I-dont-knoww/RobotTourV2/electronics/encoderpcb/jlcpcb/production_files/BOM-rotour_mt6701_breakout.csv

Comment | Designator | Footprint | LCSC | Quantity
100n | C1 | C_0402_1005Metric | C1525 | 1
Conn_01x07_MountingPin | J1 | JST_SH_SM07B-SRSS-TB_1x07-1MP_P1.00mm_Horizontal | C160406 | 1
5.6 | D1 | D_SOD-123 | C19077402 | 1
MT6701QT | U1 | QFN-16-1EP_3x3mm_P0.5mm_EP1.7x1.7mm | C2913974 | 1
