I-dont-knoww/RobotTourV2/electronics/mainpcb/IC12_MP6550_MNP.step

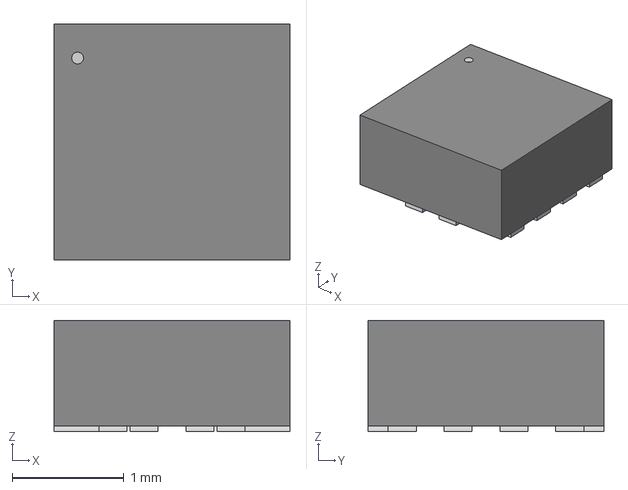
[picture p1: CAD file, 2026-01-05]
electronics/mainpcb/IC12_MP6550_MNP.step
2.11 x 2.11 x 0.993 mm
