I-dont-knoww/RobotTourV2/electronics/mainpcb/TS-1088-AR02016.step

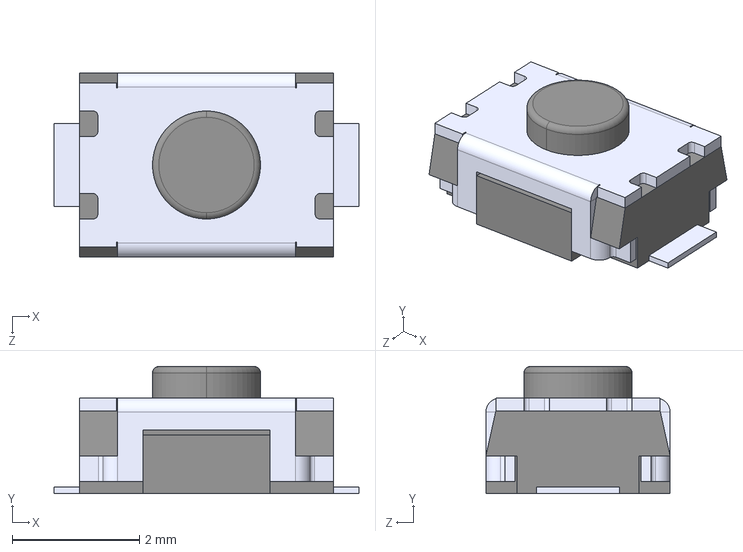
[picture p2: CAD file, 2026-01-05]
electronics/mainpcb/TS-1088-AR02016.step
4.80 x 2.00 x 2.90 mm
