I-dont-knoww/RobotTourV2/electronics/mainpcb/ICM42688.step

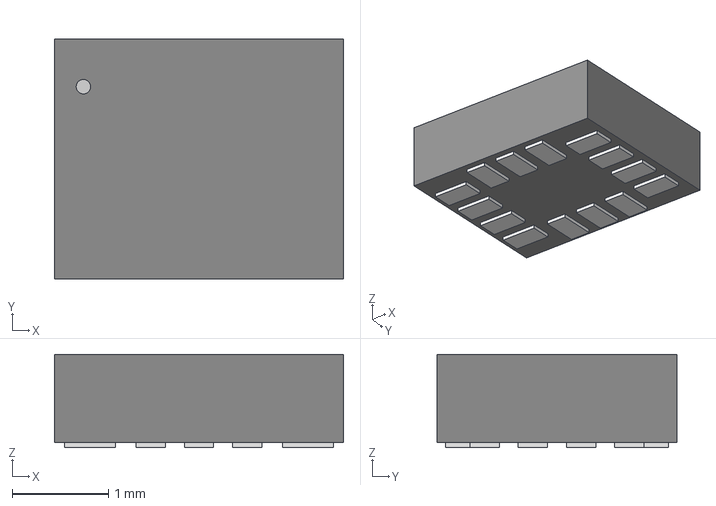
[picture p3: CAD file, 2026-01-05]
electronics/mainpcb/ICM42688.step
3.00 x 2.49 x 0.968 mm
