I-dont-knoww/RobotTourV2/electronics/mainpcb/rotour_v2.kicad_pcb

## KiCad design electronics/mainpcb/rotour_v2.kicad_pcb (2026-04-16)

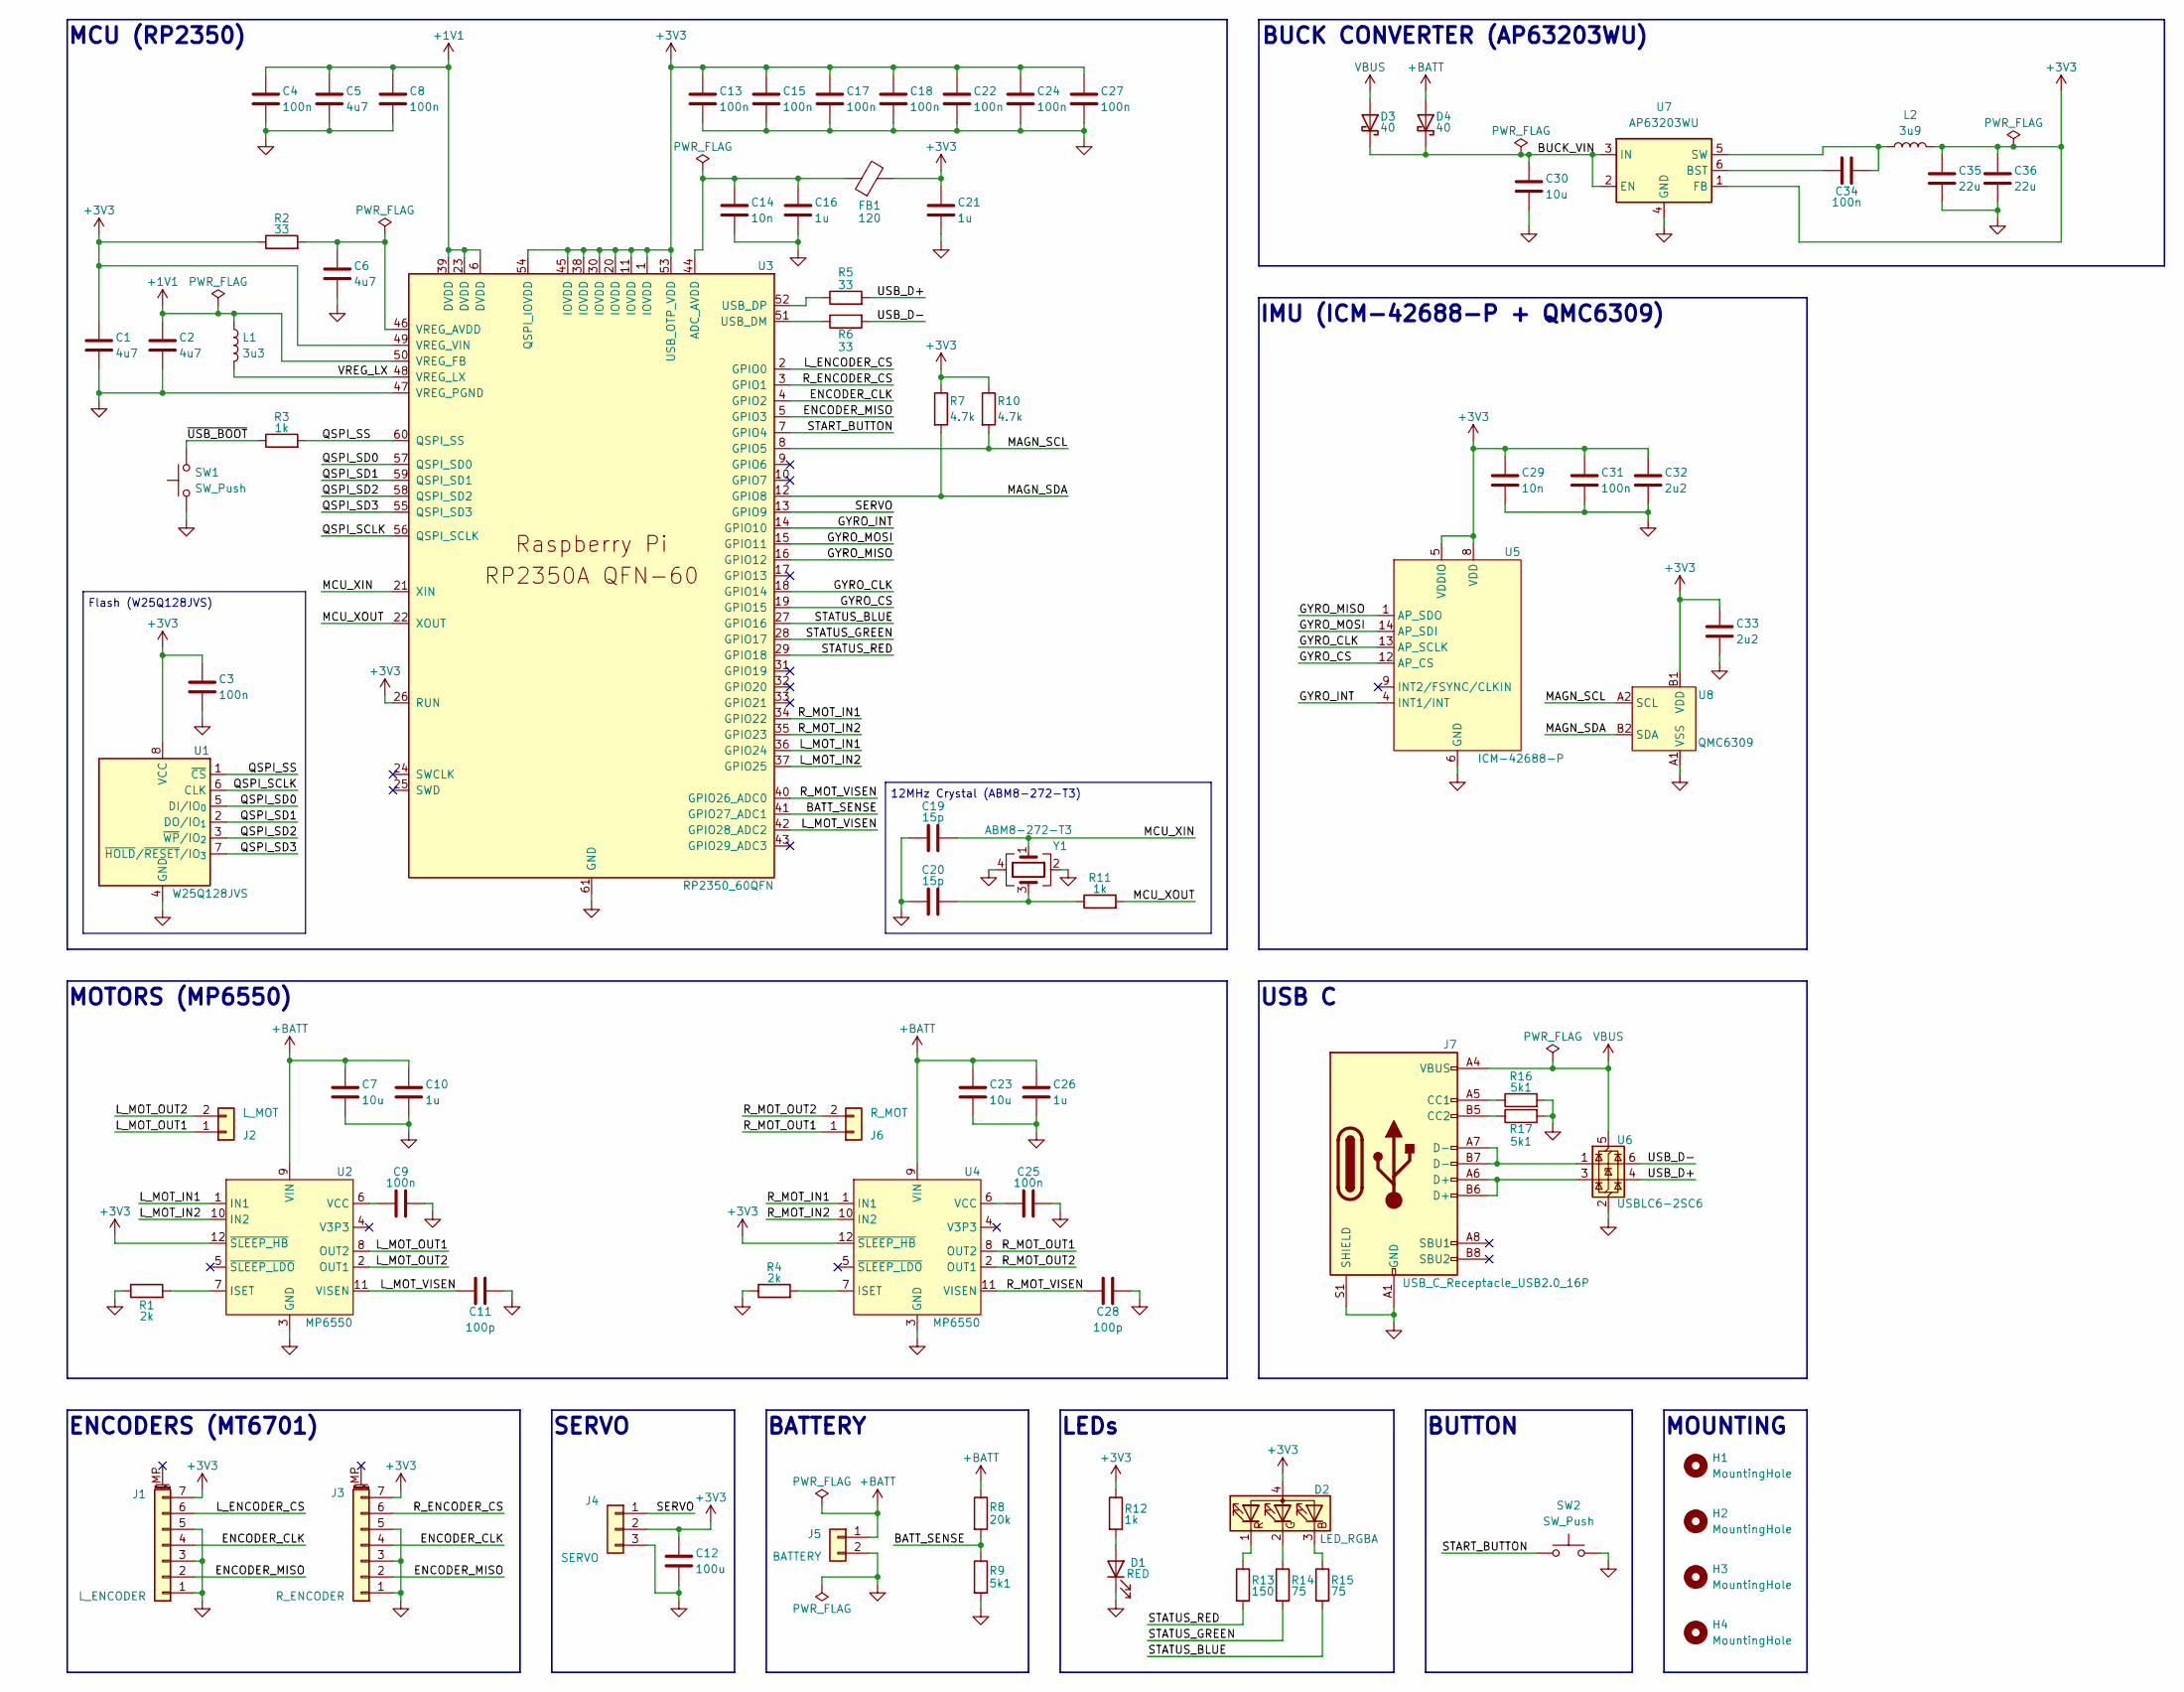
[picture p4: schematic rotour_v2.kicad_sch]

Parts:
C1, C2: 4u7; C_0402_1005Metric_small_pads
C3, C4, C8, C9, C13, C15, C17, C18, C22, C24, C25, C27, C31, C34: 100n; C_0402_1005Metric
C5, C6: 4u7; C_0402_1005Metric
C7, C23, C30: 10u; C_0603_1608Metric
C10, C16, C21, C26: 1u; C_0402_1005Metric
C11, C28: 100p; C_0402_1005Metric
C12: 100u; C_1206_3216Metric
C14, C29: 10n; C_0402_1005Metric
C19, C20: 15p; C_0402_1005Metric
C32, C33: 2u2; C_0402_1005Metric
C35, C36: 22u; C_0603_1608Metric
D1: RED; LED_0603_1608Metric
D2: LED_RGBA; LED_RGB_1210
D3, D4: 40; D_SOD-323
FB1: 120; L_0603_1608Metric
H1, H2, H3, H4: MountingHole; MountingHole_2.2mm_M2
J1: L_ENCODER; JST_SH_BM07B-SRSS-TB_1x07-1MP_P1.00mm_Vertical
J2: L_MOT; JST_XH_B2B-XH-A_1x02_P2.50mm_Vertical
J3: R_ENCODER; JST_SH_BM07B-SRSS-TB_1x07-1MP_P1.00mm_Vertical
J4: SERVO; PinHeader_1x03_P2.54mm_Vertical
J5: BATTERY; JST_VH_B2P-VH_1x02_P3.96mm_Vertical
J6: R_MOT; JST_XH_B2B-XH-A_1x02_P2.50mm_Vertical
J7: USB_C_Receptacle_USB2.0_16P; USB_C_Receptacle_GCT_USB4105-xx-A_16P_TopMnt_Horizontal
L1: 3u3; AOTA-B201610S3R3-101-T
L2: 3u9; L_Changjiang_FNR3012S
R1, R4: 2k; R_0402_1005Metric
R2, R5, R6: 33; R_0402_1005Metric
R3, R11, R12: 1k; R_0402_1005Metric
R7, R10: 4.7k; R_0402_1005Metric
R8: 20k; R_0603_1608Metric
R9, R16, R17: 5k1; R_0402_1005Metric
R13: 150; R_0603_1608Metric
R14, R15: 75; R_0603_1608Metric
SW1, SW2: SW_Push; SW_TS-1088-AR02016
U1: W25Q128JVS; SOIC-8_5.3x5.3mm_P1.27mm
U2, U4: MP6550
U3: RP2350_60QFN; QFN-60-1EP_7x7mm_P0.4mm_EP3.4x3.4mm_ThermalVias
U5: ICM-42688-P; ICM42688P
U6: USBLC6-2SC6; SOT-23-6
U7: AP63203WU; TSOT-23-6
U8: QMC6309
Y1: ABM8-272-T3; Crystal_SMD_3225-4Pin_3.2x2.5mm

Connections:
+1V1: C2.1, C4.1, C5.1, C8.1, L1.1, U3.6 (DVDD), U3.23 (DVDD), U3.39 (DVDD), U3.50 (VREG_FB)
+3V3: C1.1, C3.1, C12.1, C13.1, C15.1, C17.1, C18.1, C21.1, C22.1, C24.1, C27.1, C29.1, C31.1, C32.1, C33.1, C35.1, C36.1, D2.4 (A), FB1.2, J1.7, J3.7, J4.2, L2.2, R2.1, R7.1, R10.1, R12.1, U1.8 (VCC), U2.12 (~SLEEP_HB), U3.1 (IOVDD), U3.11 (IOVDD), U3.20 (IOVDD), U3.26 (RUN), U3.30 (IOVDD), U3.38 (IOVDD), U3.45 (IOVDD), U3.49 (VREG_VIN), U3.53 (USB_OTP_VDD), U3.54 (QSPI_IOVDD), U4.12 (~SLEEP_HB), U5.5 (VDDIO), U5.8 (VDD), U7.1 (FB), U8.B1 (VDD)
+BATT: C7.1, C10.1, C23.1, C26.1, D4.2 (A), J5.1, R8.1, U2.9 (VIN), U4.9 (VIN)
/BATT_SENSE: R8.2, R9.1, U3.41 (GPIO27_ADC1)
/BUCK_VIN: C30.1, D3.1 (K), D4.1 (K), U7.2 (EN), U7.3 (IN)
/ENCODER_CLK: J1.4, J3.4, U3.4 (GPIO2)
/ENCODER_MISO: J1.2, J3.2, U3.5 (GPIO3)
/GYRO_CLK: U3.18 (GPIO14), U5.13 (AP_SCLK)
/GYRO_CS: U3.19 (GPIO15), U5.12 (AP_CS)
/GYRO_INT: U3.14 (GPIO10), U5.4 (INT1/INT)
/GYRO_MISO: U3.16 (GPIO12), U5.1 (AP_SDO)
/GYRO_MOSI: U3.15 (GPIO11), U5.14 (AP_SDI)
/L_ENCODER_CS: J1.6, U3.2 (GPIO0)
/L_MOT_IN1: U2.1 (IN1), U3.36 (GPIO24)
/L_MOT_IN2: U2.10 (IN2), U3.37 (GPIO25)
/L_MOT_OUT1: J2.1, U2.8 (OUT2)
/L_MOT_OUT2: J2.2, U2.2 (OUT1)
/L_MOT_VISEN: C11.1, U2.11 (VISEN), U3.42 (GPIO28_ADC2)
/MAGN_SCL: R10.2, U3.8 (GPIO5), U8.A2 (SCL)
/MAGN_SDA: R7.2, U3.12 (GPIO8), U8.B2 (SDA)
/MCU_XIN: C19.2, U3.21 (XIN), Y1.1
/MCU_XOUT: R11.2, U3.22 (XOUT)
/QSPI_SCLK: U1.6 (CLK), U3.56 (QSPI_SCLK)
/QSPI_SD0: U1.5 (DI/IO_{0}), U3.57 (QSPI_SD0)
/QSPI_SD1: U1.2 (DO/IO_{1}), U3.59 (QSPI_SD1)
/QSPI_SD2: U1.3 (~WP/IO_{2}), U3.58 (QSPI_SD2)
/QSPI_SD3: U1.7 (~HOLD/~RESET/IO_{3}), U3.55 (QSPI_SD3)
/QSPI_SS: R3.2, U1.1 (~CS), U3.60 (QSPI_SS)
/R_ENCODER_CS: J3.6, U3.3 (GPIO1)
/R_MOT_IN1: U3.34 (GPIO22), U4.1 (IN1)
/R_MOT_IN2: U3.35 (GPIO23), U4.10 (IN2)
/R_MOT_OUT1: J6.1, U4.8 (OUT2)
/R_MOT_OUT2: J6.2, U4.2 (OUT1)
/R_MOT_VISEN: C28.1, U3.40 (GPIO26_ADC0), U4.11 (VISEN)
/SERVO: J4.1, U3.13 (GPIO9)
/START_BUTTON: SW2.1, U3.7 (GPIO4)
/STATUS_BLUE: R15.2, U3.27 (GPIO16)
/STATUS_GREEN: R14.2, U3.28 (GPIO17)
/STATUS_RED: R13.2, U3.29 (GPIO18)
/USB_D+: R5.2, U6.4 (I/O2)
/USB_D-: R6.2, U6.6 (I/O1)
/VREG_LX: L1.2, U3.48 (VREG_LX)
/~USB_BOOT: R3.1, SW1.2
GND: C1.2, C2.2, C3.2, C4.2, C5.2, C6.2, C7.2, C8.2, C9.2, C10.2, C11.2, C12.2, C13.2, C14.2, C15.2, C16.2, C17.2, C18.2, C19.1, C20.1, C21.2, C22.2, C23.2, C24.2, C25.2, C26.2, C27.2, C28.2, C29.2, C30.2, C31.2, C32.2, C33.2, C35.2, C36.2, D1.1 (K), J1.1, J1.3, J1.5, J3.1, J3.3, J3.5, J4.3, J5.2, J7.A1 (GND), J7.A12 (GND), J7.B1 (GND), J7.B12 (GND), J7.S1 (SHIELD), R1.1, R4.1, R9.2, R16.2, R17.2, SW1.1, SW2.2, U1.4 (GND), U2.3 (GND), U3.47 (VREG_PGND), U3.61 (GND), U4.3 (GND), U5.6 (GND), U5.7 (RESV), U5.11 (RESV), U6.2 (GND), U7.4 (GND), U8.A1 (VSS), Y1.2, Y1.4
unnamed: C20.2, R11.1, Y1.3
unnamed: D1.2 (A), R12.2
unnamed: D2.3 (BK), R15.1
unnamed: D2.2 (GK), R14.1
unnamed: D2.1 (RK), R13.1
unnamed: J7.A5 (CC1), R16.1
unnamed: J7.B5 (CC2), R17.1
unnamed: J7.A6 (D+), J7.B6 (D+), U6.3 (I/O2)
unnamed: J7.A7 (D-), J7.B7 (D-), U6.1 (I/O1)
unnamed: R1.2, U2.7 (ISET)
unnamed: C9.1, U2.6 (VCC)
unnamed: C14.1, C16.1, FB1.1, U3.44 (ADC_AVDD)
unnamed: R6.1, U3.51 (USB_DM)
unnamed: R5.1, U3.52 (USB_DP)
unnamed: C6.1, R2.2, U3.46 (VREG_AVDD)
unnamed: R4.2, U4.7 (ISET)
unnamed: C25.1, U4.6 (VCC)
unnamed: C34.2, U7.6 (BST)
unnamed: C34.1, L2.1, U7.5 (SW)
VBUS: D3.2 (A), J7.A4 (VBUS), J7.A9 (VBUS), J7.B4 (VBUS), J7.B9 (VBUS), U6.5 (VBUS)

Notes on the sheet:
BUCK CONVERTER (AP63203WU)
USB C
IMU (ICM-42688-P + QMC6309)
ENCODERS (MT6701)
BUTTON
MOTORS (MP6550)
SERVO
Flash (W25Q128JVS)
LEDs
MCU (RP2350)
12MHz Crystal (ABM8-272-T3)
BATTERY
MOUNTING

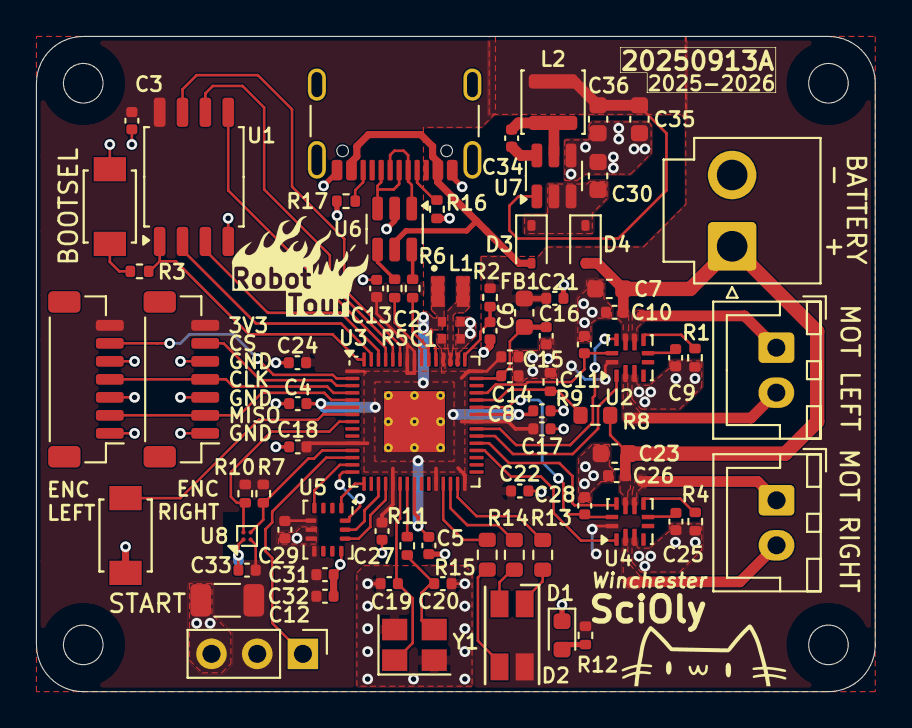
[picture p5: board rotour_v2.kicad_pcb from above]

Board: 2 copper layers, 46.6 x 36.4 mm, 82 parts (0 on the bottom side), 64 nets.
