I-dont-knoww/RobotTourV2/electronics/encoderpcb/rotour_mt6701_breakout.kicad_pcb

## KiCad design electronics/encoderpcb/rotour_mt6701_breakout.kicad_pcb (2026-01-05)

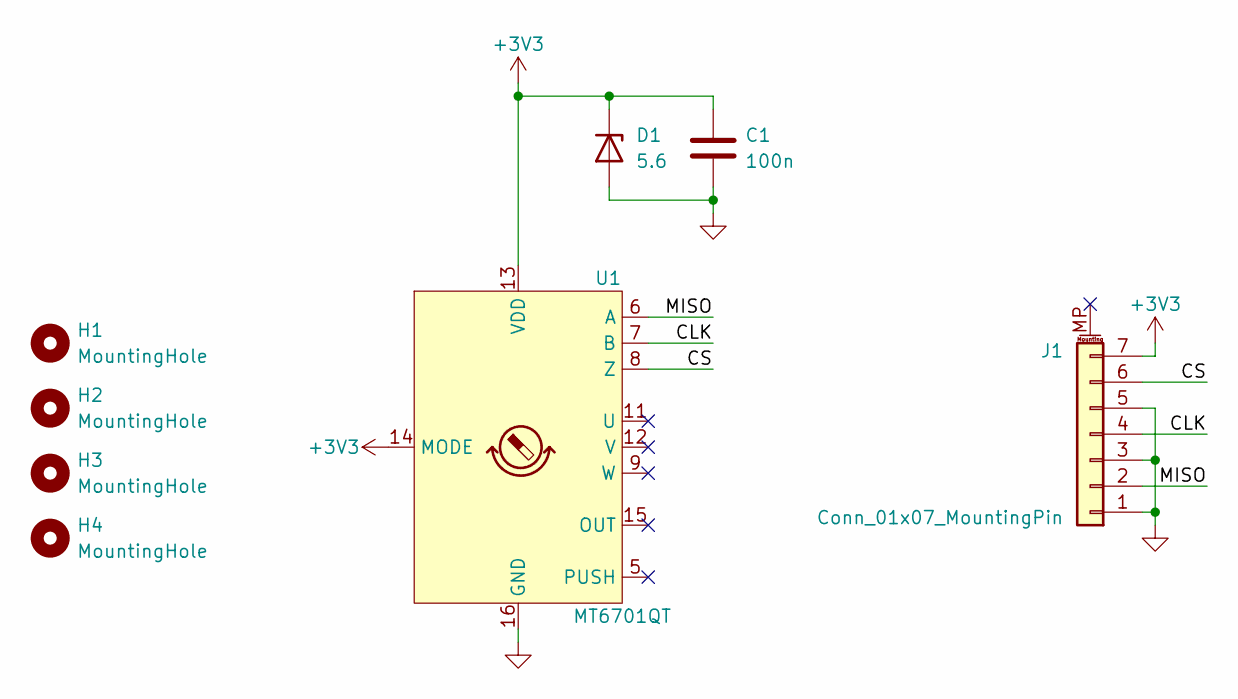
[picture p6: schematic rotour_mt6701_breakout.kicad_sch]

Parts:
C1: 100n; C_0402_1005Metric
D1: 5.6; D_SOD-123
H1, H2, H3, H4: MountingHole; MountingHole_2.2mm_M2
J1: Conn_01x07_MountingPin; JST_SH_SM07B-SRSS-TB_1x07-1MP_P1.00mm_Horizontal
U1: MT6701QT; QFN-16-1EP_3x3mm_P0.5mm_EP1.7x1.7mm

Connections:
+3V3: C1.1, D1.1 (K), J1.7, U1.13 (VDD), U1.14 (MODE)
/CLK: J1.4, U1.7 (B)
/CS: J1.6, U1.8 (Z)
/MISO: J1.2, U1.6 (A)
GND: C1.2, D1.2 (A), J1.1, J1.3, J1.5, U1.16 (GND), U1.17 (GND)

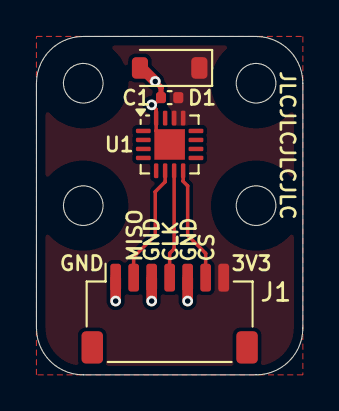
[picture p7: board rotour_mt6701_breakout.kicad_pcb from above]

Board: 2 copper layers, 14.8 x 18.8 mm, 8 parts (1 on the bottom side), 5 nets.
