I-dont-knoww/RobotTourV2/include/path/Competition.hpp

#pragma once

#include "path/Compiler.hpp"
#include "path/Path.hpp"

#include "state/Vector.hpp"

#include <array>

// are you on the right branch?
// did you set the FAIL_RUN variable?
// did you set the target time?
// did you check the destination?

namespace Competition {
    using namespace Compiler::Tokens;

    inline constexpr bool FAIL_RUN = false;
    inline constexpr float TARGET_TIME = 71.0f;

    inline constexpr auto COMMANDS = std::to_array<Compiler::Command>({
        // clang-format off

        FIRST_MOVE,

        moveby(LEFT),
        moveby(UP),
        moveby(DOWN),
        moveby(RIGHT),
        moveby(RIGHT),
        moveby(UP),
        moveby(LEFT),
        moveby(0.7f * UP),
        moveby(0.7f * DOWN) & REVERSE,
        moveby(RIGHT),
        moveby(UP),
        moveby(0.7f * DOWN),
        moveby(0.7f * UP) & REVERSE,
        moveby(UP),
        moveby(LEFT),
        moveby(LEFT),
        moveby(UP),
        moveby(DOWN),
        moveby(RIGHT),
        moveby(0.7f * RIGHT),
        moveby(0.7f * LEFT) & REVERSE,
        moveby(LEFT),
        moveby(UP),
        moveby(LEFT),
        moveby(RIGHT),
        moveby(0.7f * RIGHT),
        moveby(0.7f * LEFT) & REVERSE,
        moveby(LEFT) & OFFSET_ONCE(2.5f * UP + 0.8f * RIGHT) & LAST_MOVE,

        // clang-format on
    });

    inline constexpr auto PATH = Compiler::compile(COMMANDS);
    inline constexpr auto TARGET_TIMES = Compiler::getTargetTimes(COMMANDS, PATH, TARGET_TIME);
    inline constexpr auto TURN_TIMES = Compiler::TargetTime::getTurnTimes(PATH);
    inline constexpr Vec2 DESTINATION = Compiler::getDestination(PATH) / SQUARE_SIZE;
}
