I-dont-knoww/RobotTourV2/(commit log)

2025-10-03 pio i2c for compass
2025-10-05 moved forward kinematics onto core1 and now using repeating_timer to time the sampling
2025-11-11 updated straight.cpp to avoid the jerking movement on non-90 deg turns and updated follower to fix max path length being 102 somehow.
    [Competition.hpp, Compiler.hpp, Constants.hpp, main.cpp]
2025-11-12 made it calibrate the current sensing bias because we are totally using that right now
2025-11-14 fixed time allocation to dedicated turns
    [Competition.hpp, Compiler.hpp, Constants.hpp]
2025-11-17 fixed fast loop and slow loop dt being slightly off
    [Constants.hpp]
2025-11-24 moved target time calculations into a namespace, moved forward kinematics update into several lines, fully stopped using encoders for position updates, fixed small bug in limiting battery voltage in 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
    [Competition.hpp, Compiler.hpp, main.cpp]
2025-11-29 moved around final status print stuff and made it print final angle as well now
2025-11-29 fixed print statement
2025-12-16 centripetal limiting telemetry and also sorta fixed
    [Competition.hpp, Constants.hpp, main.cpp]
2025-12-16 final tuning and testing of centripetal limiting before test at track
2025-12-16 added failed run feature
    [Competition.hpp, Constants.hpp, main.cpp]
2025-12-17 added a filter to the centripetal limit so that there is less jerkiness in linear velocity when centripetal limiting matters
2025-12-17 clamped filteredmaxlinearspeed so that nothing goofy happens when maxLinearSpeed is too high for too long
2025-12-19 fixed compiler to handle reverse 90 degree turns correctly
    [Compiler.hpp]
2026-01-05 added electronics folder
    [BOM-rotour_v2.csv, IC12_MP6550_MNP.step, ICM42688.step, TS-1088-AR02016.step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]
2026-01-05 added encoderpcb to electronics folder
    [BOM-rotour_mt6701_breakout.csv, BOM-rotour_v2.csv, IC12_MP6550_MNP.step, ICM42688.step, TS-1088-AR02016.step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]
2026-01-08 thin wheel rt new constants
2026-01-10 fixed fakeout holy cow the solution was so simple what the actual heck
    [Competition.hpp, Constants.hpp]
2026-01-11 jk the solution was a bit more advanced but now its fr dealt with, idk abt completely fixed tho
    [Constants.hpp]
2026-01-11 switched to std::atomic instead of weird user defined atomic after confirming std::atomic lowk works
2026-01-14 removed random comment saying 8.3cm
2026-01-14 implemented new alg for speed, something is not working down the line
    [Competition.hpp, Constants.hpp, Motors.cpp]
2026-01-14 fixed some goofy ahh bug where there was this problem with an AController in the velocity regulator, goofy coz were not freakin using the A Controller. also reduced slowdownkp to demonstrate POWER of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
    [Competition.hpp, Constants.hpp]
2026-01-18 sort of fixed weird stopping at lower speeds, though the solution is super goofy
    [Competition.hpp, Constants.hpp, main.cpp]
2026-01-19 ok lowk genuinely fixed all those goofy centripetal problems
    [Competition.hpp, Compiler.hpp, Constants.hpp]
2026-02-26 computed wheel radius
2026-03-05 tentative gyroscope filtering
2026-03-07 likely fixed most bugs with speedup acceleration for both straight and rotation
    [Competition.hpp, Constants.hpp]
2026-03-31 updated electronics to kicad 10
    [rotour_v2.kicad_pcb, rotour_v2.kicad_sch]
2026-04-16 updated pcb 3d models
    [rotour_v2.kicad_pcb]
